hamzava/smart-stick-for-visually-impaired/Docs/Interim Material/Block Diagram.jpg

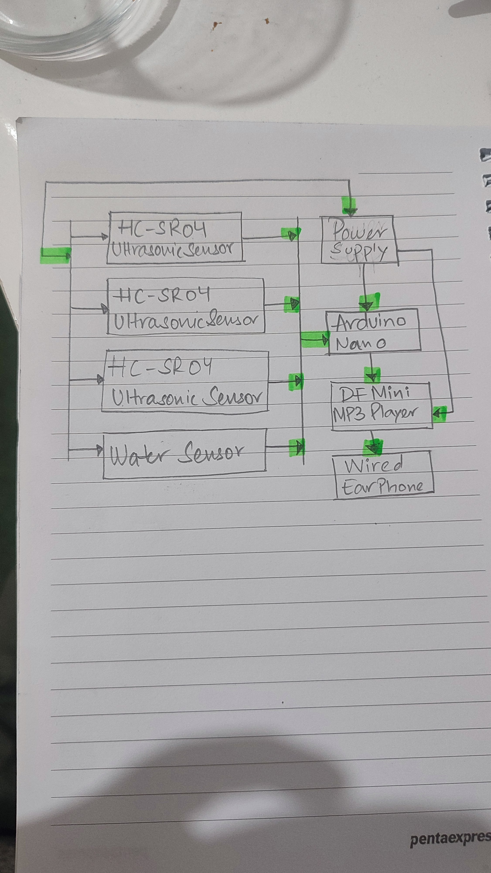
Docs/Interim Material/Block Diagram.jpg
