hamzava/smart-stick-for-visually-impaired/Docs/Images/Stick.jpg

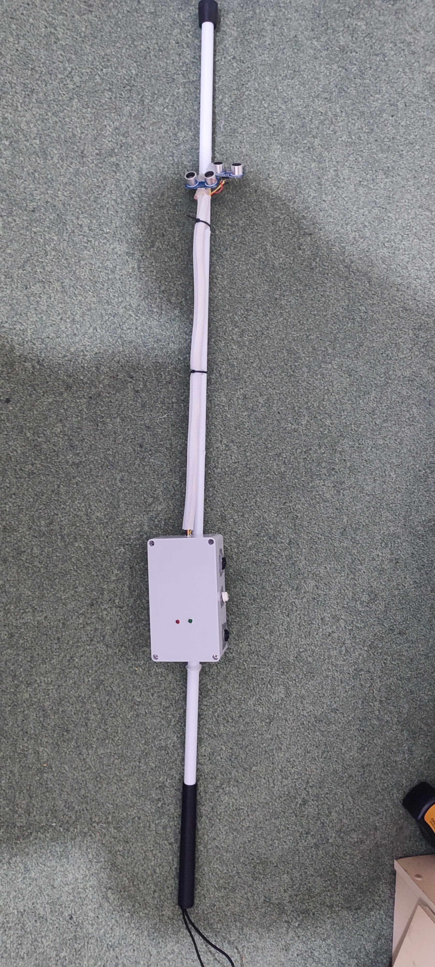
Docs/Images/Stick.jpg
