hamzava/smart-stick-for-visually-impaired/README.md

# Smart Stick for the Visually Impaired

A modern assistive device designed to help visually impaired individuals navigate their surroundings safely.  
This project enhances the traditional walking stick with embedded technology, obstacle detection, and emergency communication features.

---

## 📖 Overview
Visually impaired individuals face difficulties in movement due to loss of visual acuity or reduced field of view.  
The **Smart Stick** aims to partially overcome this challenge by integrating modern electronics into a traditional navigation tool.  

Key features include:
- **Obstacle detection** using an ultrasonic sensor.
- **Emergency SOS system** with GPS and GSM modules to send location data to a predefined contact.
- **Lightweight and practical design**, based on Arduino Nano with ATmega328 microcontroller.

---

## 🎥 Demo Video

Watch the demo video (https://www.youtube.com/watch?v=r47kOy3oFZc)

---

## 🛠️ Features
- **Ultrasonic Obstacle Detection**: Detects nearby objects and alerts the user.
- **SOS Button**: Sends an emergency message with GPS coordinates via GSM network.
- **GPS Integration**: Provides real-time location in emergencies.
- **Arduino Nano Control**: Efficient and compact microcontroller at the core of the system.

---

## ⚙️ Hardware Components
- Arduino Nano (ATmega328)
- Ultrasonic Sensor (HC-SR04)
- GPS Module (NEO-6M)
- GSM Module (SIM800L)
- Push Button (for SOS trigger)
- Power Supply ( Lithium Ion battery pack)

---
