hamzava/smart-stick-for-visually-impaired/Docs/Misc/Current Requirements.xlsx

 | Idle | Standby | On | Burst | Voltage
HC-SR04 x 3 | <2mA |  | 15mA |  | 5
Neo-6M | 11mA | 39mA | 47mA |  | 2.7-3.6V
Sim800l | 18.7mA |  | 453.57mA | 2A | 4
DFMp3Player |  | 20mA |  |  | 4.2
Arduino Nano | 30mA | 30mA | 50mA |  | 9
