hamzava/smart-stick-for-visually-impaired/Docs/Flowcharts/sim800l.drawio.png

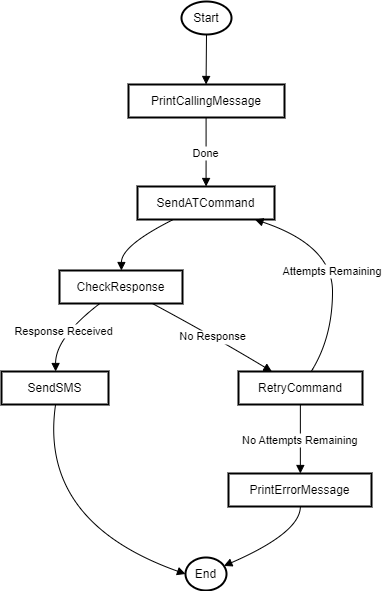
Docs/Flowcharts/sim800l.drawio.png
