hamzava/smart-stick-for-visually-impaired/Docs/Images/Led's.jpg

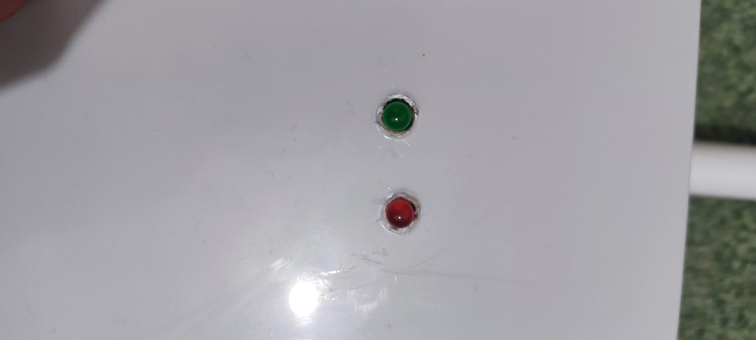
Docs/Images/Led's.jpg
