hamzava/smart-stick-for-visually-impaired/Docs/Images/Sensors.jpg

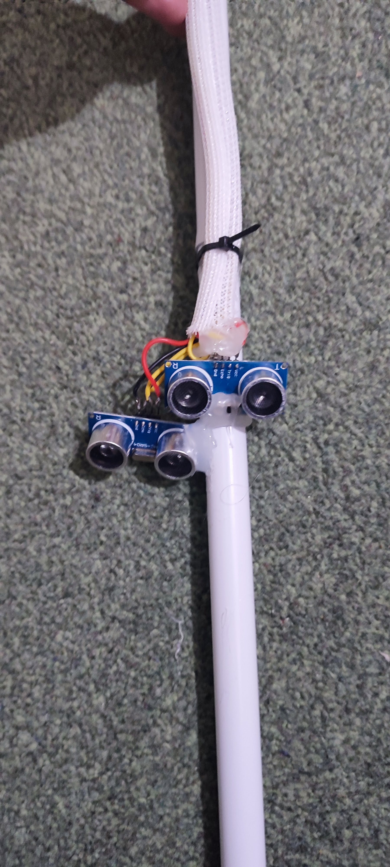
Docs/Images/Sensors.jpg
