hamzava/smart-stick-for-visually-impaired/Docs/Interim Material/Design/Angles 1.png

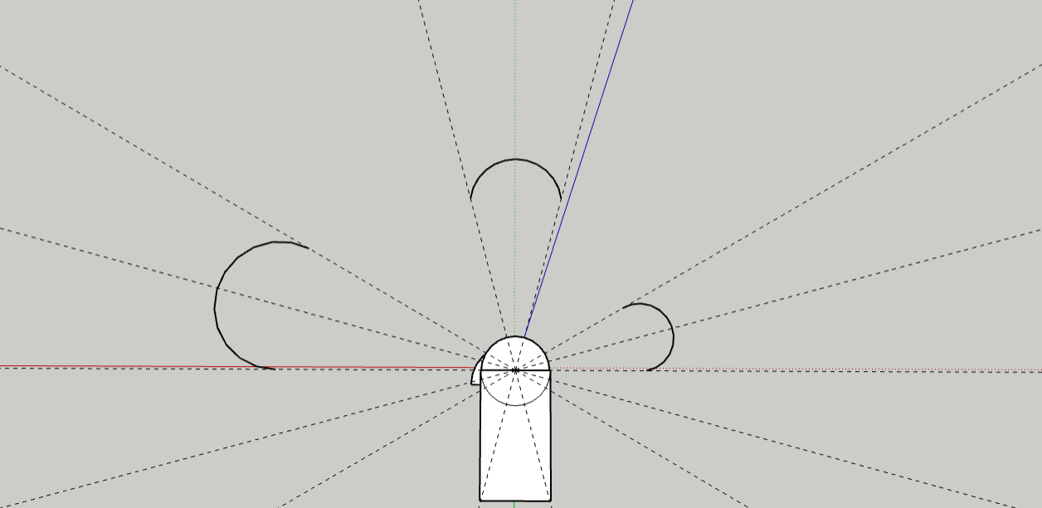
Docs/Interim Material/Design/Angles 1.png
