hamzava/smart-stick-for-visually-impaired/Docs/Interim Material/Design/Screenshot 2023-11-08 195511.png

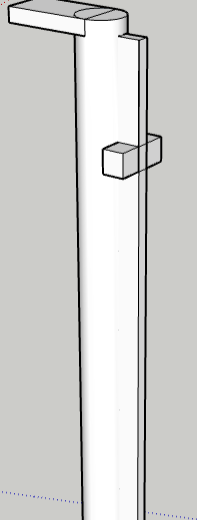
Docs/Interim Material/Design/Screenshot 2023-11-08 195511.png
