hamzava/smart-stick-for-visually-impaired/Docs/Interim Material/Design/side.png

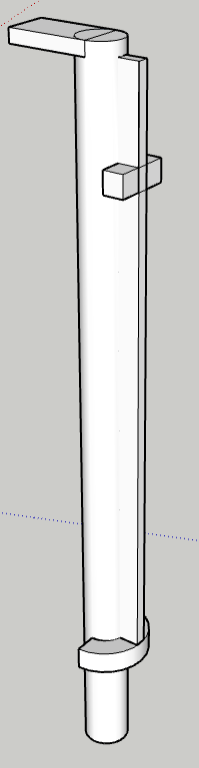
Docs/Interim Material/Design/side.png
