hamzava/smart-stick-for-visually-impaired/Docs/Misc/Battery_Calcutions.jpg

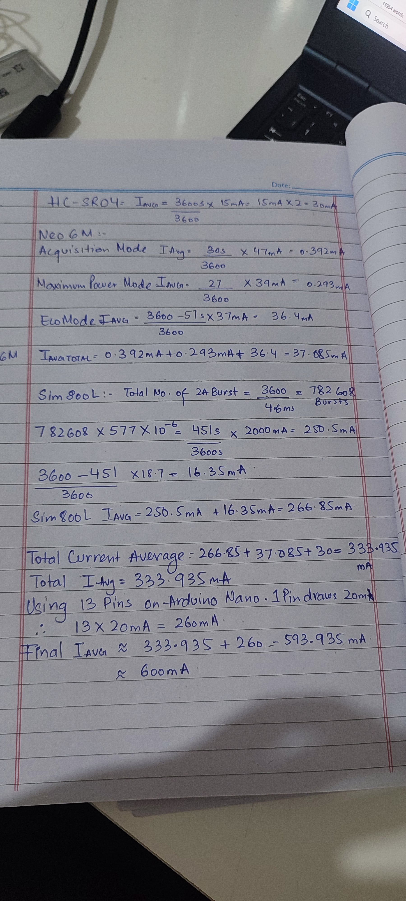
Docs/Misc/Battery_Calcutions.jpg
