hamzava/smart-stick-for-visually-impaired/Docs/Misc/LED_Calcs.jpg

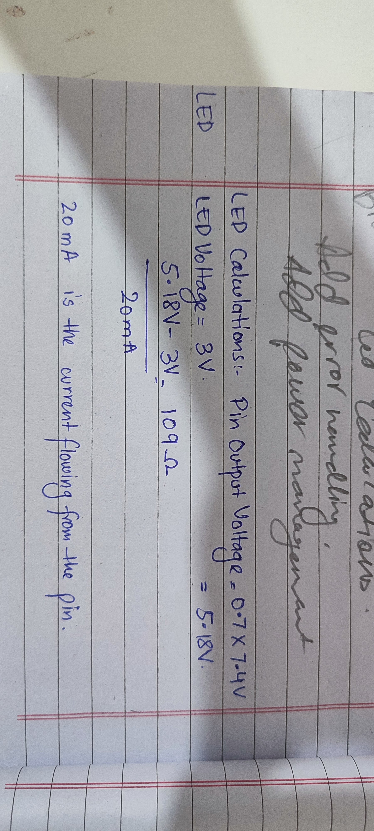
Docs/Misc/LED_Calcs.jpg
