hamzava/smart-stick-for-visually-impaired/Project Brief.png

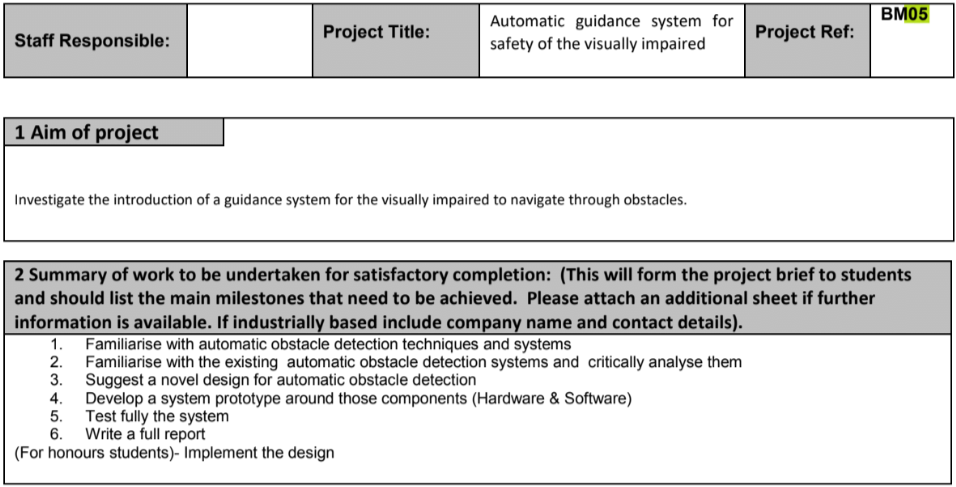
Project Brief.png
