hamzava/smart-stick-for-visually-impaired/Docs/Interim Material/Gantt_Chart_v1.pdf

2023 | 30 | 6 | 13 | 20 | 27 | 4 | 11 | 18 | 25 | 1 | 8 | 15 | 22 | 29
Oct '23 | Nov '23 | Dec '23 | Jan '24 | Feb '24
Automatic Guidance System... | 0h | 0%
Research | 0h | 0%
Research Obstacle Detection techniq... | 0 | 0%
Research any existing systems relat... | 0 | 0%
Research possible designs. | 0 | 0%
Research the components required. | 0 | 0%
Research the economic viability. | 0 | 0%
Develop a strategy for prototyping. | 0 | 0%
Develop a strategy to mitigate possib... | 0 | 0%
Phase 1 Complete | 0 | 0%
Test & Design Phase | 0h | 0%
Design the PCB. | 0 | 0%
Design the firmware. | 0 | 0%
Develop a working prototype. | 0 | 0%
Test the prototype for hardware and ... | 0 | 0%
Design the body/casing. | 0 | 0%
Test the body/casing for possible faul... | 0 | 0%
Do a risk assessment of the PCB and... | 0 | 0%
Interim Report | 0 | 0%
Phase 2 complete | 0 | 0%
Implementation | 0h | 0%
Submit the bill of material form. | 0 | 0%
Preliminary Testing. | 0 | 0%
Assemble the components. | 0 | 0%
Final Testing. | 0 | 0%
Report. | 0 | 0%
Submission | 0 | 0%

Researc
Rese
Research po
Rese
Rese
Deve
D

Design the P
Design th
Develop a
Test the p
Design
Test
D
Interim Repo

Su
Pr
Asse
Final Testi
Report.
Su

Powered by TCPDF (www.tcpdf.org)
