hamzava/smart-stick-for-visually-impaired/Docs/Misc/Farnell Order Form.xlsx

Sheet: Sheet1
 |  |  |  |  | DFA ONLY
UNIVERSITY OF SOUTH WALES |  |  |  |  | Purchase method
FACULTY OF COMPUTING, ENGINEERING & SCIENCE |  |  |  |  | Date order raised
Please complete all the red mandatory fields, incomplete orders will not be processed. |  |  |  |  | Order Number
 |  |  |  |  | Nominal
EXPENDITURE REQUEST FORM
Section A
Date |  |  | Supplier Name and Address
Requested By |  |  | Farnell
Credit Card / Order Request? |  |  | 150 Armley Road,
Budget Code |  |  | Leeds LS12 2QQ UK
Department/Office
Authorisation (Print Name) Budget holder
 |  |  | Postcode: | LS12 2QQ
Authorisation (Signature) |  |  | Tel No: | +44 870 129 8608, 03447 11 11 11
 |  |  | Fax No: | 03447 11 11 12
Goods or Services |  |  | If Equipment, please enter room where it is to be located :
Type of Goods / Services e.g. Software / Hardware |  |  | J407
Section B - Expenditure Description
Order Code | Description |  |  | Unit Price | No of Units | Amount VAT INCLUDED
4162009 | MULTICOMP HC-SR04 ULTRASONIC DISTANCE SENSOR |  |  | £3.11 | 3 | £9.33
3517866 | DFROBOT DFR0299 DFPlayer Module |  |  | £5.36 | 2 | £10.72
1848691 | Arduino Nano [A000005] |  |  | £19.20 | 1 | £19.20
3126565 | Battery Holder AA 4 |  |  | £0.65 | 2 | £1.30
 |  |  |  |  |  | £40.55
Total |  |  |  |  |  | £48.66
Grand Total (Amount + VAT)
Section C Vehicle Hire PLEASE REFUEL VEHICLE
Delivery Date & Time
Delivery Point
Collection Date & Time
Collection Point
Vehicle Type / Description
Name(s) of Driver(s)
Purpose of Hire
Other Details : D.O.B |  | Flight no. : | Contact No. |  |  | Other Info
Driving Licence No. |  | Start date: | End Date
Failure to Refuel Vehicle will result in additional Charges and possible removal of service
Section D Accommodation Requirements ( only to be completed if not included in Uniglobe / Portman quote)
Name of Hotel
Address of Hotel
Hotel Telephone No / Fax No.
Dates Required
Number of Rooms Required
Names of Personnel
Additional Info Web address / Ref
Please submit electronically via email to: AT Expenditure Requests (AT)

Sheet: Sheet2
Credit Card | Goods | Electronic
Purchase Order | Services | Email attached

Sheet: Sheet3
Component | Arduino Nano Pin | Connection
Fingerprint RX | 2 | RX on fingerprint sensor
Fingerprint TX | 3 | TX on fingerprint sensor
Password | Not a pin
Relay COM | 5V | 5V on Arduino Nano
Relay NO | Solenoid + | Positive terminal on solenoid
Relay IN | 4 | IN on relay
Solenoid - | GND | GND on Arduino Nano
LED1 anode (+) | 6 | 6 on Arduino Nano
LED1 cathode (-) | GND | GND on Arduino Nano
LED2 anode (+) | 7 | 7 on Arduino Nano
LED2 cathode (-) | GND | GND on Arduino Nano
Fingerprint GND | GND | GND on Arduino Nano
Relay GND | GND | GND on Arduino Nano
Solenoid GND | GND | GND on Arduino Nano
Fingerprint VCC | 5V | 5V on Arduino Nano
