hamzava/smart-stick-for-visually-impaired/Docs/Misc/Logbook.docx

23.10.2023 14:56

Researching Obstacle Detection Methods.

Read a couple of research papers. Wrote down the relevant info on the notes.docx file. Researched the prices of the modules. Decided which one is the most suitable method for our project.

24.10.2023 20:10

More research on obstacle detection methods.

Read about infrared and ultrasonic sensors in depth. Decided to choose ultrasonic sensors for our project.

Prepared rough designs which are possible by hand drawing.

25.10.2023 15:50

Researching Components. Firstly Ultrasonic Sensor which will be the core of the design. I am also looking what microprocessor should I go for. It seems it will be an Arduino as Ultrasonic Sensors are compatible with arduinos

30.10.2023 15:00

Reading a few research papers to see what has already been done and what has to be done. Decided to use ultrasonic sensors,3 of them. We might be able to use a 4th one as well but it depends on the prototype. Water Sensor will be ordered but it is still to be determined if it will be helpful or not. Things to decide: which Arduino to use? Finalize the design as well. Do a risk assessment and then design the PCB. I think I will be able to do this by the end of this week. Also need to draw a trigonometric drawing of the design.

31.10.2023 18:30

Researching what Arduino should I use or should I go for a single microprocessor. Decided to go for Arduino nano.

Design draft 1 completed. Component research was going on simultaneously but putting it to writing for today. I might submit the form next week to Jamie as I need to talk to him. But I’ll be prepared as I need components for the prototype.

Order form partially completed. Need to add a power supply a rechargeable one preferably. For that next up I will calculate the required calculations etc. By tomorrow, or Friday 03.11.2023 I shall have Order Form and Design draft. Risk Assessment will be left which can be done by the end of the week. Also I read an interesting research experiment on the measurement accuracy of the ultra sonic sensor on github which will be really helpful ahead. I suspect that I won’t need 3 sensors after reading it. By tasks, I think I am slightly late as there was a lot of decision making and reading but I have almost 9 days to design the PCB as well, which I guess should take less than 2 days. After I have designed the PCB, I will start working on the interim report.

02.11.2023 19:29

Drew block diagram. Finished Order Form. Did some calculations for current as I need the relevant power source.

Will finalize calculations tomorrow. Risk Assessment will be done by tomorrow. I might be able to start the interim report. Prototyping Strategy is finalized. Economic Viability is finalized. Used only 50% of the budget for ordering the components.

03.11.2023 16:18

Starting interim report. Wrote 727 words.

05.11.2023 15:57

ontinuing to write the interim report. Risk Assessment partially done. 1238 word completed.

08.11.2023 18:45

3D modelled my proposed design using Google Sketchup online for the interim report. Interim Report stands at 1481 words. Made a few changes in the Gantt chart.

[[ Not updated after November ]]
