hamzava/smart-stick-for-visually-impaired/Software/sim800l_withbutton_working/sim800l_withbutton_working.ino

#include<SoftwareSerial.h>

SoftwareSerial sim800l(7, 6); // tx, rx
#define BUTTON_PIN 8 // Pin where the button is connected

boolean buttonPressed = false;

//---------------------------------------------------------------------------------------------
boolean getResponse(String expected_answer, unsigned int timeout = 1000) {
  boolean flag = false;
  String response = "";
  unsigned long previous;
  //*************************************************************
  for (previous = millis(); (millis() - previous) < timeout;) {
    while (sim800l.available()) {
      response = sim800l.readString();
      if (response.indexOf(expected_answer) > 0) {
        flag = true;
        goto OUTSIDE;
      }
    }
  }
  //*************************************************************
  OUTSIDE:
  if (response != "") { Serial.println(response); }
  return flag;
}
//---------------------------------------------------------------------------------------------
boolean tryATcommand(String cmd, String expected_answer, int timeout, int total_tries) {
TryAgain:
  //*************************************************************
  for (int i = 1; i <= total_tries; i++) {
    sim800l.println(cmd);
    if (getResponse(expected_answer, timeout) == true) {
      break;
    }
    else {
      Serial.print(".");
    }
  }
  //*************************************************************
}

void setup() {

  pinMode(LED_BUILTIN, OUTPUT);
  pinMode(BUTTON_PIN, INPUT);

  sim800l.begin(9600);
  Serial.begin(9600);

  tryATcommand("ATE", "OK", 1000, 20);
  tryATcommand("AT", "OK", 1000, 20);
  tryATcommand("AT+CMGF=1", "OK", 1000, 20);
  tryATcommand("AT+CNMI=1,2,0,0,0", "OK", 1000, 20);
}

void loop() {
  // Check if the button is pressed
  if (digitalRead(BUTTON_PIN) == HIGH && !buttonPressed) {
    // Button is pressed, send SMS
    sendSMS("447888196873", "Button pressed!"); // Replace with the actual phone number
    Serial.println("Button Pressed");

    // Mark the button as pressed to avoid sending multiple SMS
    buttonPressed = true;
  }

  // Handle SMS and serial communication as before
  while (sim800l.available()) {
    String response = sim800l.readString();
    Serial.println(response);
    if (response.indexOf("+CMT:") > 0) {
      if (response.indexOf("ledon") > 0) {
        digitalWrite(LED_BUILTIN, HIGH);
      }
      if (response.indexOf("ledoff") > 0) {
        digitalWrite(LED_BUILTIN, LOW);
      }
    }
  }

  while (Serial.available()) {
    sim800l.println(Serial.readString());
  }

  // 1 * 60 * 1000  = 60000  = 1 Minutes
  // 15 * 60 * 1000 = 900000 = 15 Minutes
  // if (millis() - previousMillis > 900000) { // 15 Minutes interval
  //   tryATcommand("AT", "OK", 1000, 60);
  //   previousMillis = millis();
  // }
}

void sendSMS(const char* number, const char* msg) {
  tryATcommand("AT+CMGS=\"" + String(number) + "\"", ">", 1000, 5);
  sim800l.print(msg);
  sim800l.write(26); // ASCII code for Ctrl+Z to send the message
  delay(1000);
  buttonPressed = true; // Mark the button as pressed to avoid sending multiple SMS
}
